goppend/CompToXY/(list of files, drawings)

Other design files:
CompToXY.pcb
