goppend/CompToXY/(commit log)

2022-01-14 Fix pcb layout image name, update readme
2022-01-14 Add pcb layout picture back with correct name
